jmercerr/CW312T-S6LX9/CW312T-S6LX9.kicad_pcb

## KiCad design CW312T-S6LX9.kicad_pcb (2024-12-19)

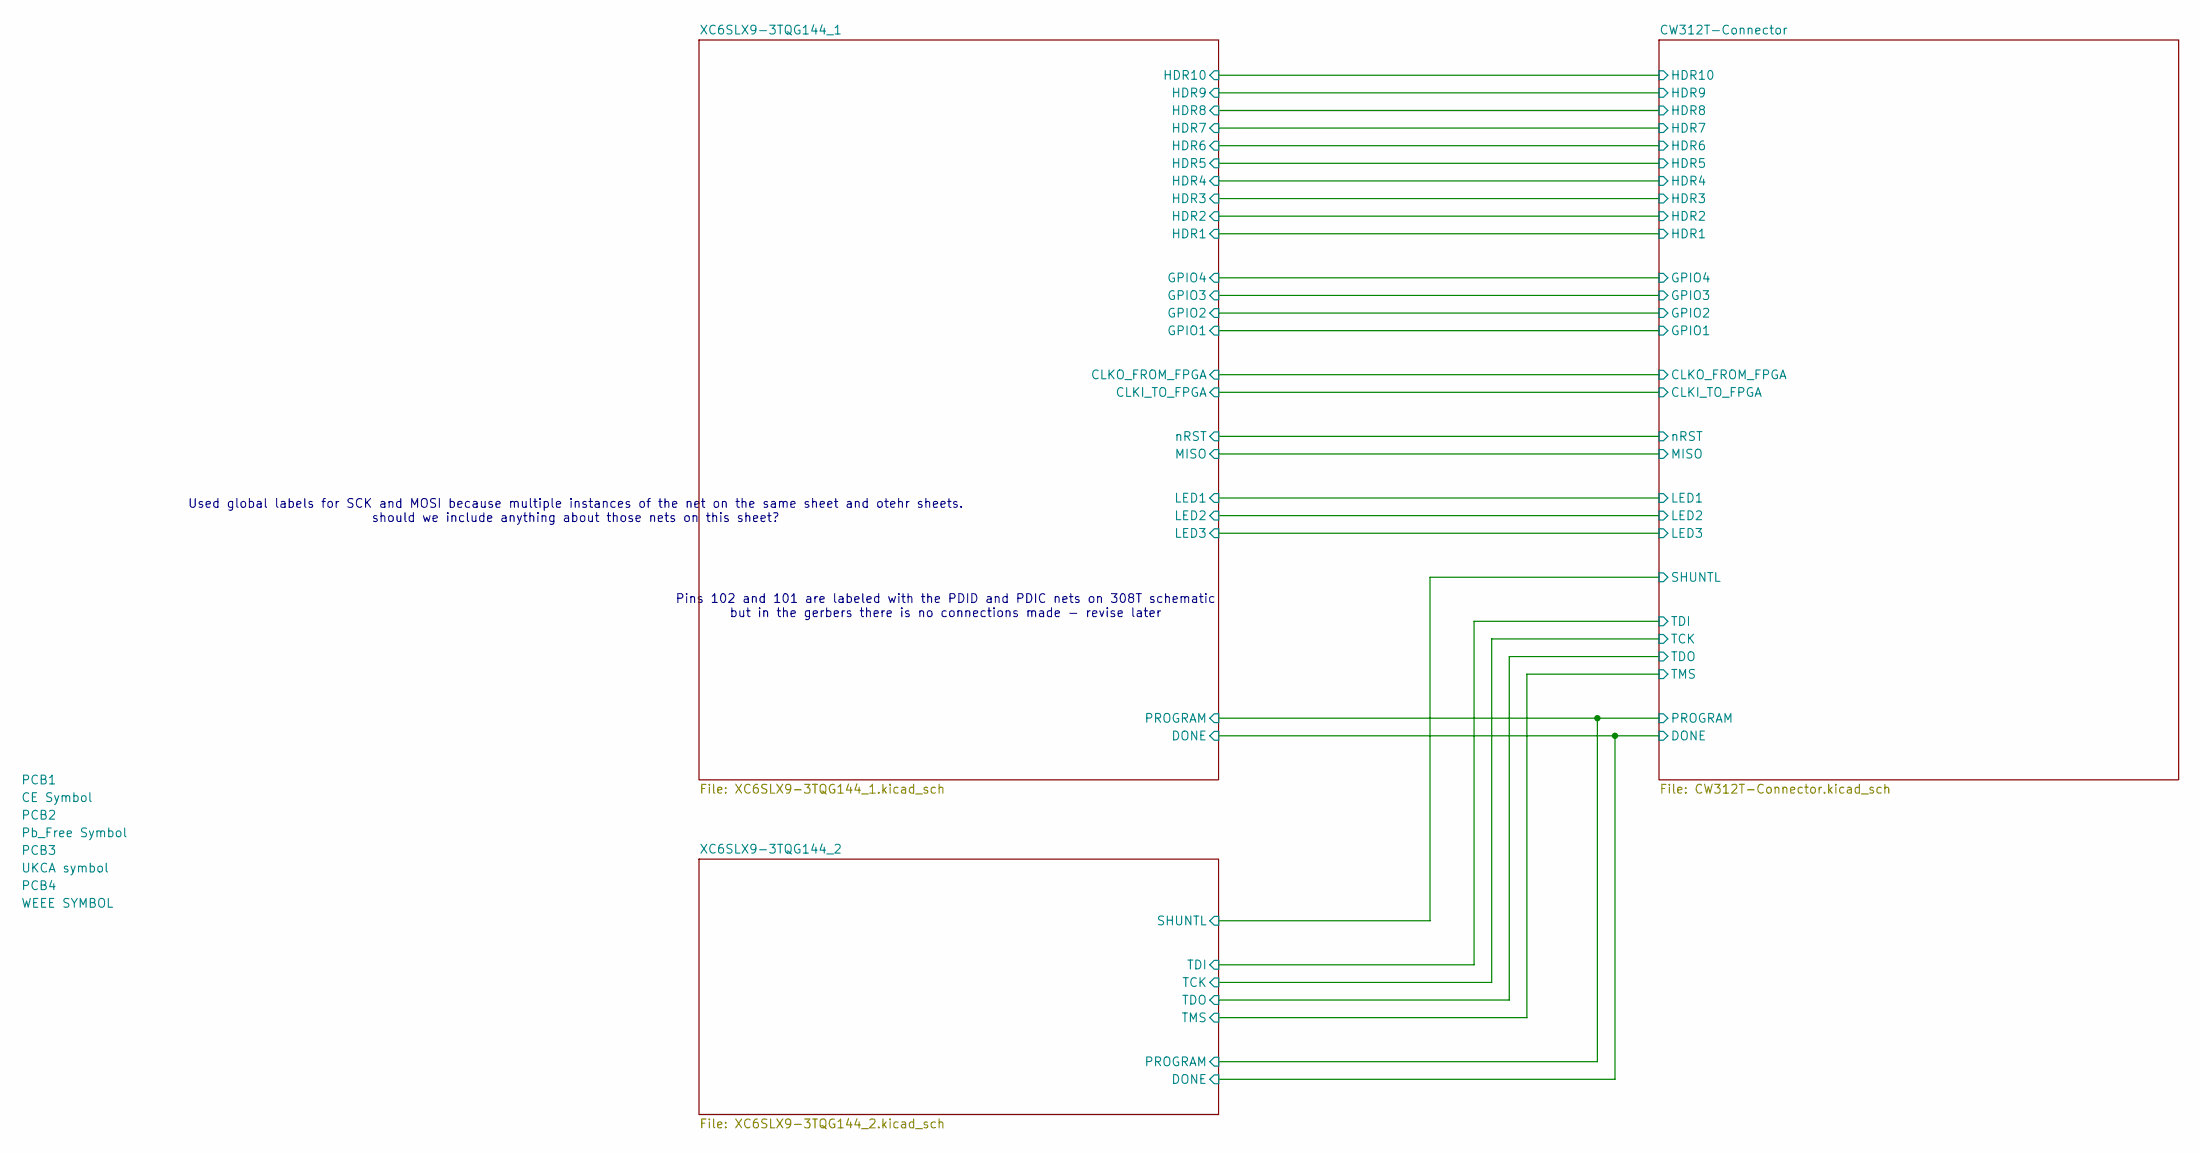
[picture p1: schematic CW312T-S6LX9.kicad_sch]

Parts:
PCB1: CE Symbol; CE-Logo_8.5x6mm_SilkScreen
PCB2: Pb_Free Symbol; Pb_Free_8.0x8.0mm_SilkScreen
PCB3: UKCA symbol; UKCA-Logo_8x8mm_SilkScreen
PCB4: WEEE SYMBOL; WEEE-Logo_5.6x8mm_SilkScreen

Notes on the sheet:
Pins 102 and 101 are labeled with the PDID and PDIC nets on 308T schematic but in the gerbers there is no connections made - revise later
Used global labels for SCK and MOSI because multiple instances of the net on the same sheet and otehr sheets. should we include anything about those nets on this sheet?

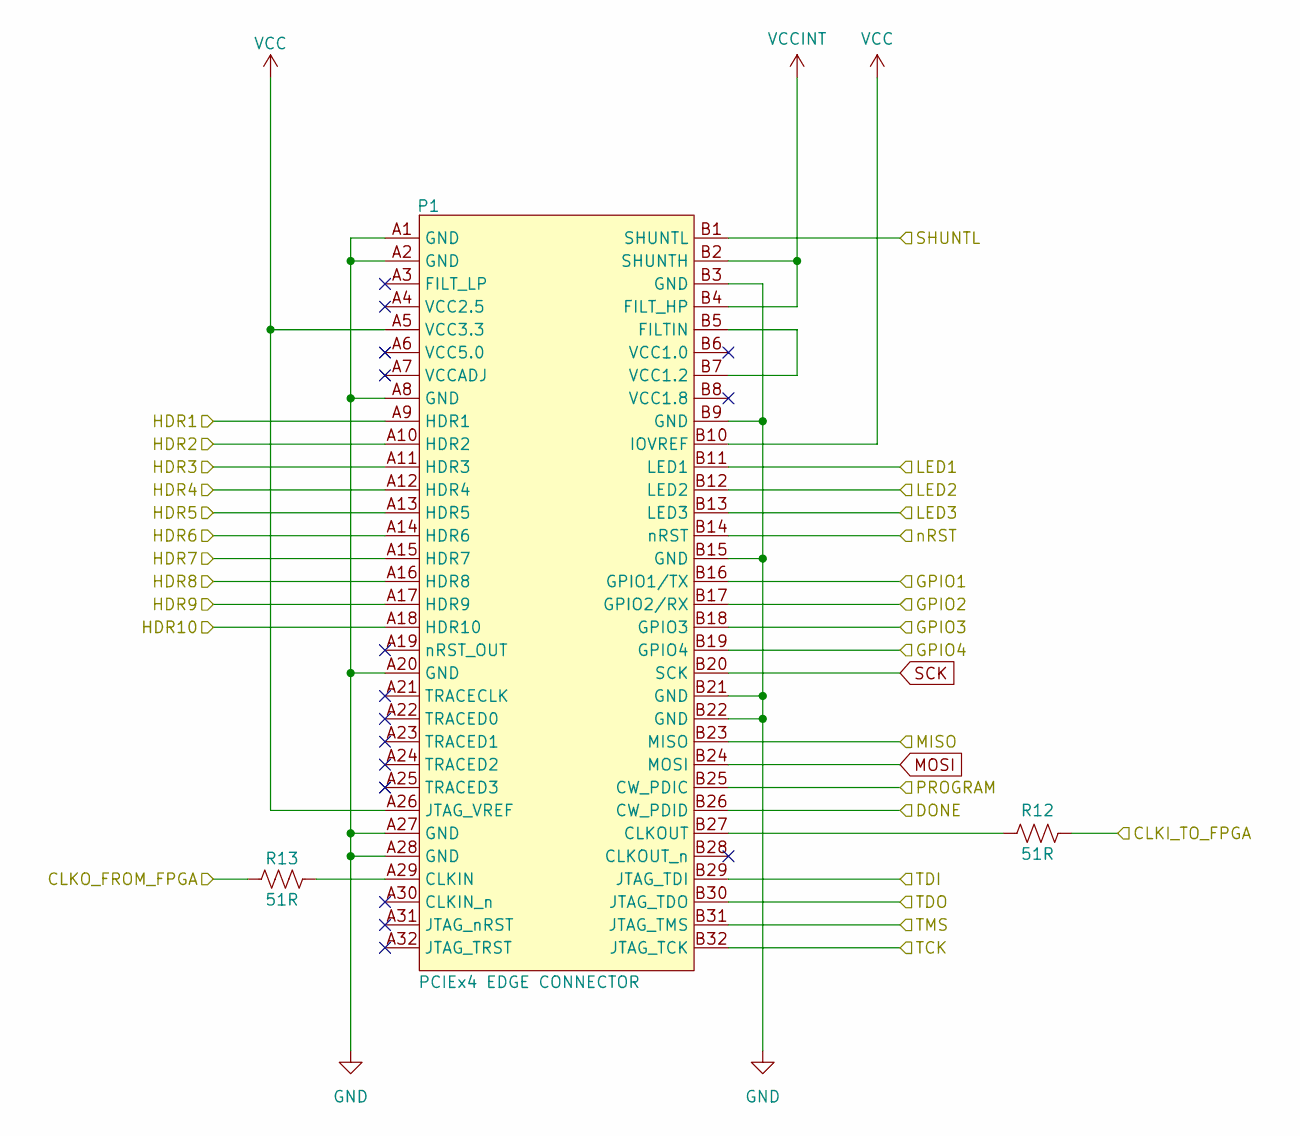
[picture p2: schematic CW312T-Connector.kicad_sch]

Parts:
P1: PCIEx4 EDGE CONNECTOR; CW312_Template
R12, R13: RES_51R_0603; R_0603_1608Metric; Manufacturer Part Number RC0603FR-0751RL

Connections:
/CW312T-Connector/CLKI_TO_FPGA: R12.2; also elsewhere on the board
/CW312T-Connector/CLKO_FROM_FPGA: R13.1; also elsewhere on the board
/CW312T-Connector/DONE: P1.B26 (CW_PDID); also elsewhere on the board
/CW312T-Connector/GPIO1: P1.B16 (GPIO1/TX); also elsewhere on the board
/CW312T-Connector/GPIO2: P1.B17 (GPIO2/RX); also elsewhere on the board
/CW312T-Connector/GPIO3: P1.B18 (GPIO3); also elsewhere on the board
/CW312T-Connector/GPIO4: P1.B19 (GPIO4); also elsewhere on the board
/CW312T-Connector/HDR1: P1.A9 (HDR1); also elsewhere on the board
/CW312T-Connector/HDR2: P1.A10 (HDR2); also elsewhere on the board
/CW312T-Connector/HDR3: P1.A11 (HDR3); also elsewhere on the board
/CW312T-Connector/HDR4: P1.A12 (HDR4); also elsewhere on the board
/CW312T-Connector/HDR5: P1.A13 (HDR5); also elsewhere on the board
/CW312T-Connector/HDR6: P1.A14 (HDR6); also elsewhere on the board
/CW312T-Connector/HDR7: P1.A15 (HDR7); also elsewhere on the board
/CW312T-Connector/HDR8: P1.A16 (HDR8); also elsewhere on the board
/CW312T-Connector/HDR9: P1.A17 (HDR9); also elsewhere on the board
/CW312T-Connector/HDR10: P1.A18 (HDR10); also elsewhere on the board
/CW312T-Connector/LED1: P1.B11 (LED1); also elsewhere on the board
/CW312T-Connector/LED2: P1.B12 (LED2); also elsewhere on the board
/CW312T-Connector/LED3: P1.B13 (LED3); also elsewhere on the board
/CW312T-Connector/MISO: P1.B23 (MISO); also elsewhere on the board
/CW312T-Connector/PROGRAM: P1.B25 (CW_PDIC); also elsewhere on the board
/CW312T-Connector/SHUNTL: P1.B1 (SHUNTL); also elsewhere on the board
/CW312T-Connector/TCK: P1.B32 (JTAG_TCK); also elsewhere on the board
/CW312T-Connector/TDI: P1.B29 (JTAG_TDI); also elsewhere on the board
/CW312T-Connector/TDO: P1.B30 (JTAG_TDO); also elsewhere on the board
/CW312T-Connector/TMS: P1.B31 (JTAG_TMS); also elsewhere on the board
/CW312T-Connector/nRST: P1.B14 (nRST); also elsewhere on the board
GND: P1.A1 (GND), P1.A2 (GND), P1.A8 (GND), P1.A20 (GND), P1.A27 (GND), P1.A28 (GND), P1.B3 (GND), P1.B9 (GND), P1.B15 (GND), P1.B21 (GND), P1.B22 (GND); also elsewhere on the board
MOSI: P1.B24 (MOSI); also elsewhere on the board
unnamed: P1.A29 (CLKIN), R13.2
unnamed: P1.B27 (CLKOUT), R12.1
unnamed: P1.B5 (FILTIN), P1.B7 (VCC1.2)
SCK: P1.B20 (SCK); also elsewhere on the board
VCC: P1.A5 (VCC3.3), P1.A26 (JTAG_VREF), P1.B10 (IOVREF); also elsewhere on the board
VCCINT: P1.B2 (SHUNTH), P1.B4 (FILT_HP); also elsewhere on the board

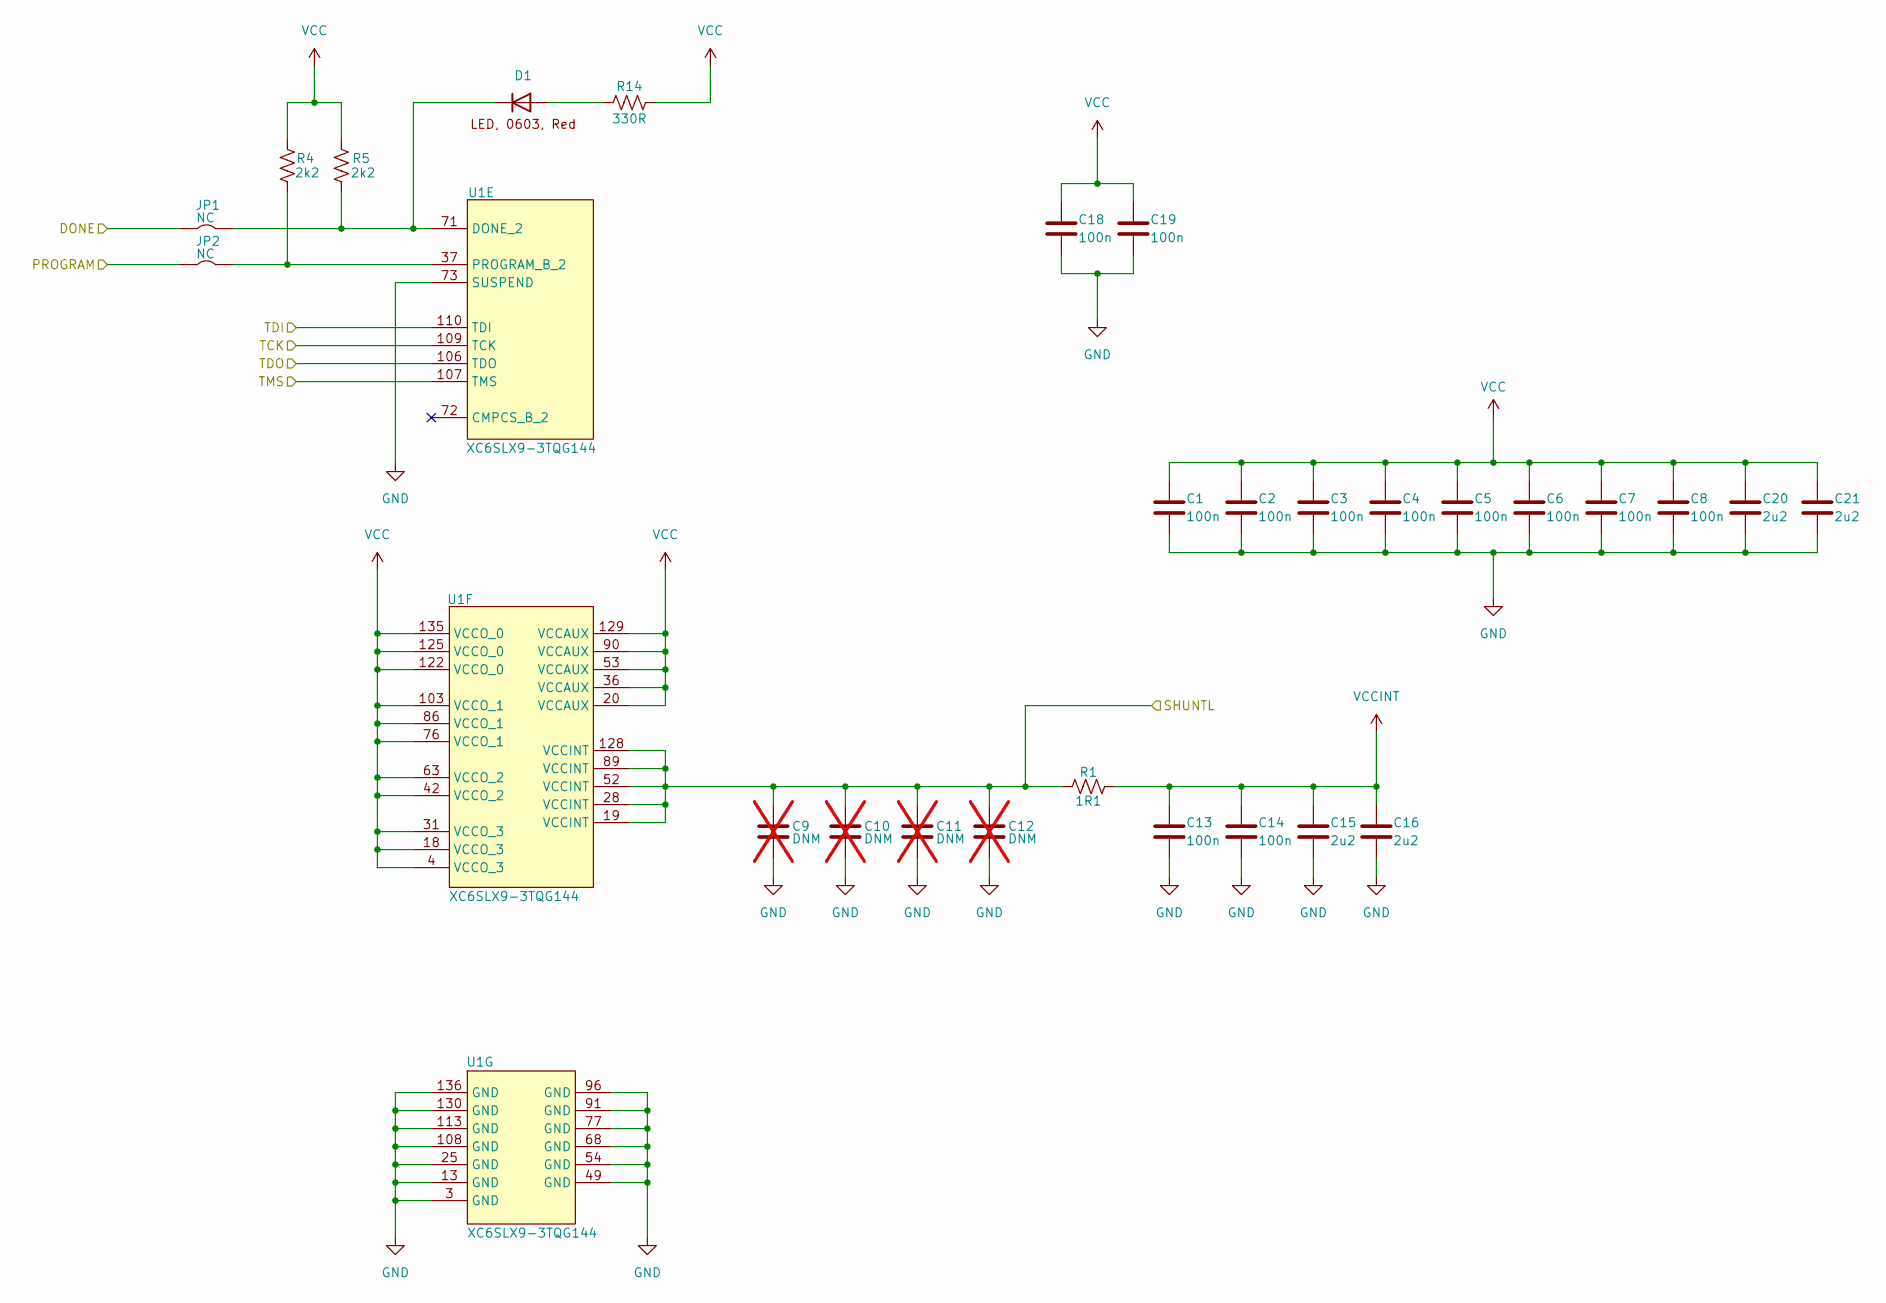
[picture p3: schematic XC6SLX9-3TQG144_2.kicad_sch]

Parts:
C1, C2, C3, C4, C5, C6, C7, C8, C13, C14, C18, C19: CAP_100n_6.3V_0603; C_0603_1608Metric; Manufacturer Part Number CC0603KRX7R5BB104
C9, C10, C11, C12: DNM_CAP_0603; C_0603_1608Metric; Manufacturer Part Number C0603C225K4PAC7867; not fitted
C15, C16, C20, C21: CAP_2u2_6.3V_0603; C_0603_1608Metric; Manufacturer Part Number CC0603KRX7R5BB225
D1: APT1608SRCPRV; LED_0603_1608Metric; Manufacturer Part Number APT1608SRCPRV
JP1, JP2: SolderJumper-2_P1.3mm_Bridged2Bar_Pad1.0x1.5mm
R1: RES_1R1_0603; R_0603_1608Metric; Manufacturer Part Number RC0603FR-101R1L
R4, R5: RES_2k2_0603; R_0603_1608Metric; Manufacturer Part Number RC0603FR-072K2L
R14: RES_330R_0603; R_0603_1608Metric; Manufacturer Part Number RC0603FR-07330RL
U1: XC6SLX9-3TQG144; TQFP-144_20x20mm_P0.5mm; Manufacturer Part Number XC6SLX9-3TQG144CXC6SLX9-3TQG144C

Connections:
/CW312T-Connector/DONE: JP1.1; also elsewhere on the board
/CW312T-Connector/PROGRAM: JP2.1; also elsewhere on the board
/CW312T-Connector/SHUNTL: C9.2, C10.2, C11.2, C12.2, R1.1, U1.19 (VCCINT), U1.28 (VCCINT), U1.52 (VCCINT), U1.89 (VCCINT), U1.128 (VCCINT); also elsewhere on the board
/CW312T-Connector/TCK: U1.109 (TCK); also elsewhere on the board
/CW312T-Connector/TDI: U1.110 (TDI); also elsewhere on the board
/CW312T-Connector/TDO: U1.106 (TDO); also elsewhere on the board
/CW312T-Connector/TMS: U1.107 (TMS); also elsewhere on the board
GND: C1.2, C2.2, C3.2, C4.2, C5.2, C6.2, C7.2, C8.2, C9.1, C10.1, C11.1, C12.1, C13.2, C14.2, C15.2, C16.2, C18.2, C19.2, C20.2, C21.2, U1.3 (GND), U1.13 (GND), U1.25 (GND), U1.49 (GND), U1.54 (GND), U1.68 (GND), U1.73 (SUSPEND), U1.77 (GND), U1.91 (GND), U1.96 (GND), U1.108 (GND), U1.113 (GND), U1.130 (GND), U1.136 (GND); also elsewhere on the board
unnamed: D1.2, R14.1
unnamed: D1.1, JP1.2, R5.1, U1.71 (DONE_2)
unnamed: JP2.2, R4.1, U1.37 (PROGRAM_B_2)
VCC: C1.1, C2.1, C3.1, C4.1, C5.1, C6.1, C7.1, C8.1, C18.1, C19.1, C20.1, C21.1, R4.2, R5.2, R14.2, U1.4 (VCCO_3), U1.18 (VCCO_3), U1.20 (VCCAUX), U1.31 (VCCO_3), U1.36 (VCCAUX), U1.42 (VCCO_2), U1.53 (VCCAUX), U1.63 (VCCO_2), U1.76 (VCCO_1), U1.86 (VCCO_1), U1.90 (VCCAUX), U1.103 (VCCO_1), U1.122 (VCCO_0), U1.125 (VCCO_0), U1.129 (VCCAUX), U1.135 (VCCO_0); also elsewhere on the board
VCCINT: C13.1, C14.1, C15.1, C16.1, R1.2; also elsewhere on the board

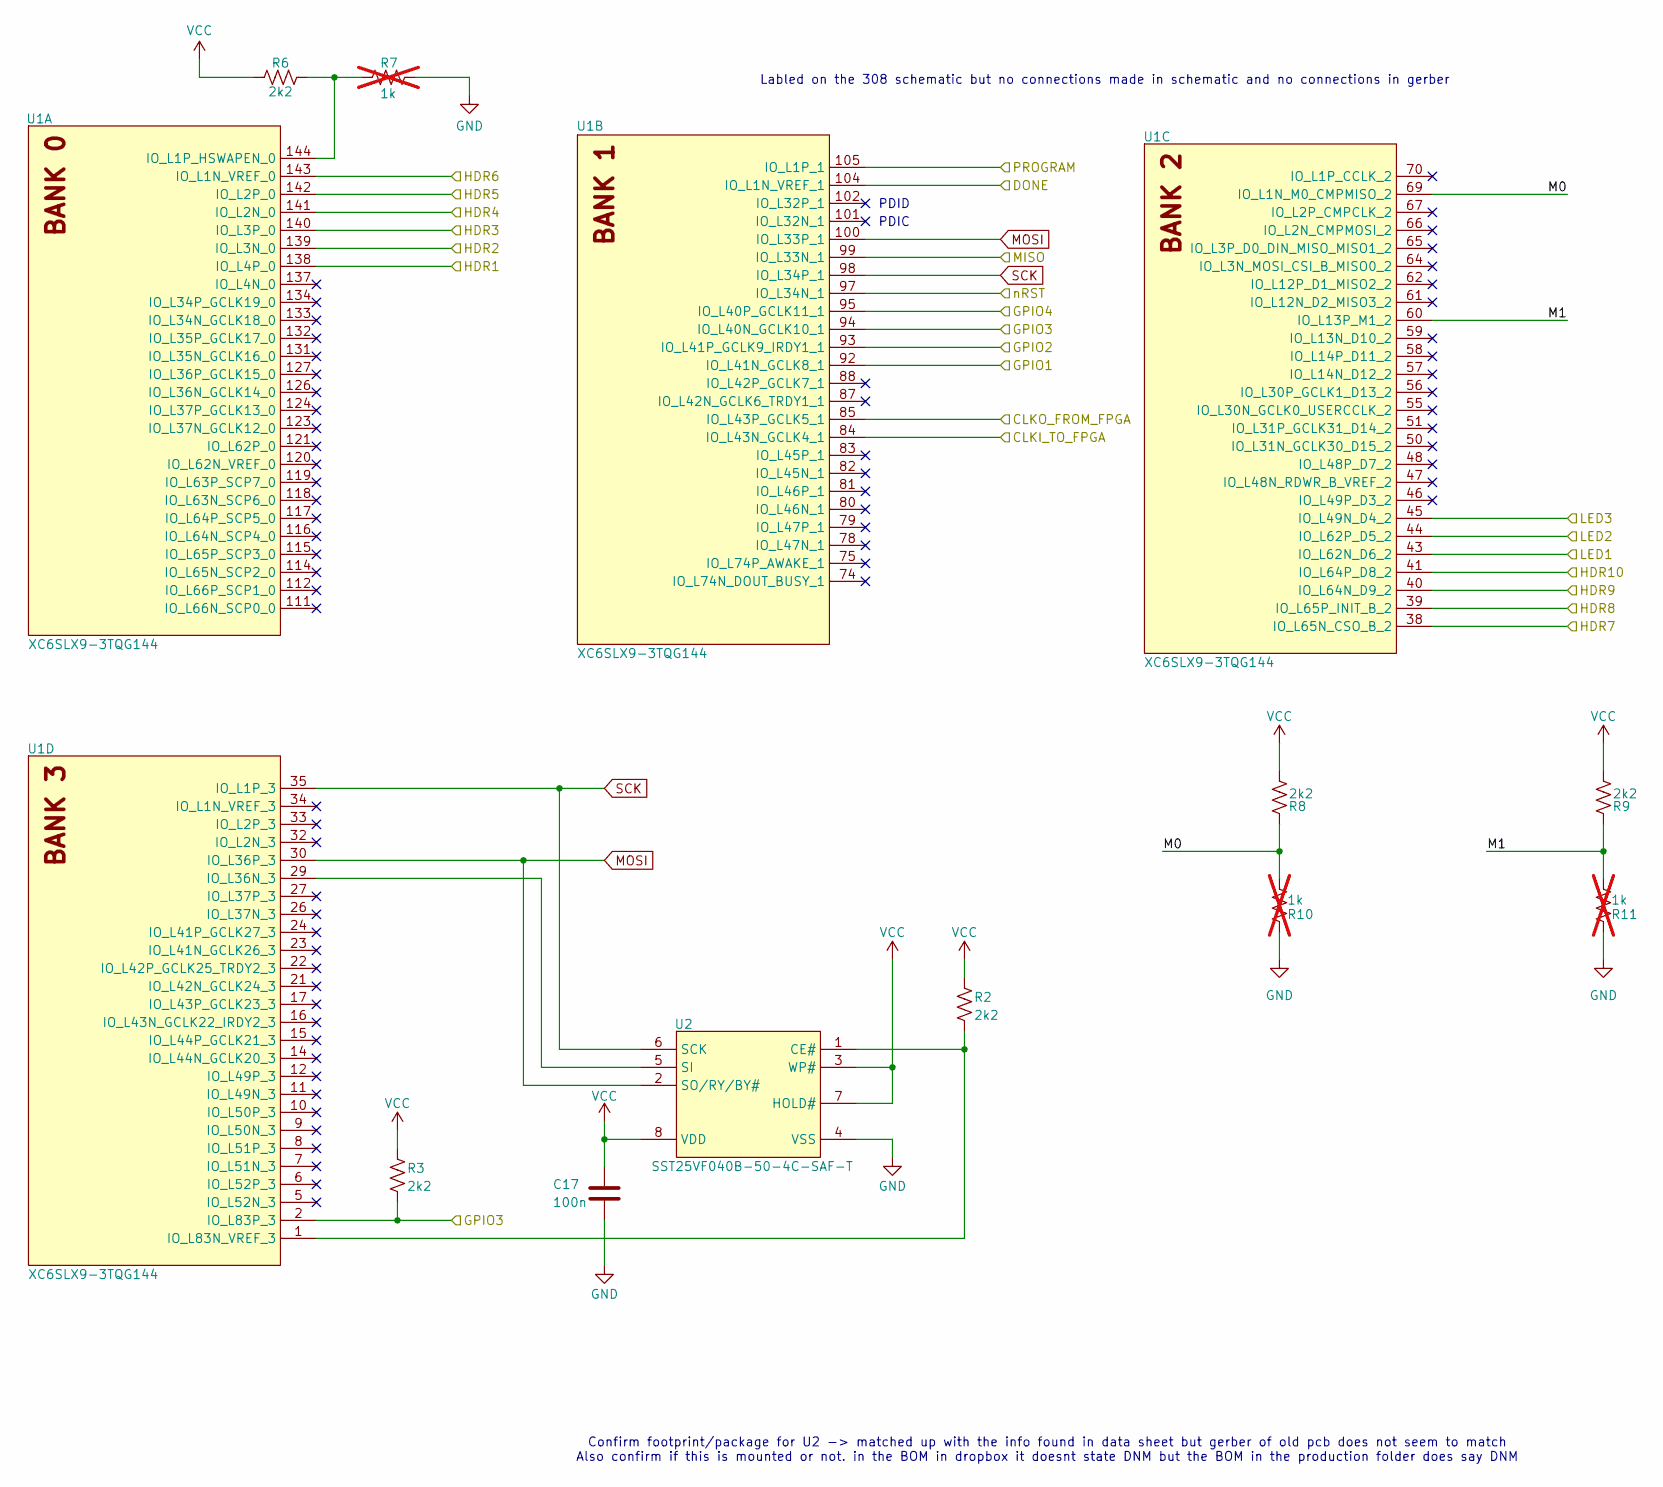
[picture p4: schematic XC6SLX9-3TQG144_1.kicad_sch]

Parts:
C17: CAP_100n_6.3V_0603; C_0603_1608Metric; Manufacturer Part Number CC0603KRX7R5BB104
R2, R3, R6, R8, R9: RES_2k2_0603; R_0603_1608Metric; Manufacturer Part Number RC0603FR-072K2L
R7, R10, R11: RES_1k_0603; R_0603_1608Metric; Manufacturer Part Number RC0603FR-071KL; not fitted
U1: XC6SLX9-3TQG144; TQFP-144_20x20mm_P0.5mm; Manufacturer Part Number XC6SLX9-3TQG144CXC6SLX9-3TQG144C
U2: SST25VF040B-50-4C-SAF-T; SOIC-8_5.275x5.275mm_P1.27mm; Manufacturer Part Number SST25VF040B-50-4C-SAF-T

Connections:
/CW312T-Connector/CLKI_TO_FPGA: U1.84 (IO_L43N_GCLK4_1); also elsewhere on the board
/CW312T-Connector/CLKO_FROM_FPGA: U1.85 (IO_L43P_GCLK5_1); also elsewhere on the board
/CW312T-Connector/DONE: U1.104 (IO_L1N_VREF_1); also elsewhere on the board
/CW312T-Connector/GPIO1: U1.92 (IO_L41N_GCLK8_1); also elsewhere on the board
/CW312T-Connector/GPIO2: U1.93 (IO_L41P_GCLK9_IRDY1_1); also elsewhere on the board
/CW312T-Connector/GPIO3: R3.1, U1.2 (IO_L83P_3), U1.94 (IO_L40N_GCLK10_1); also elsewhere on the board
/CW312T-Connector/GPIO4: U1.95 (IO_L40P_GCLK11_1); also elsewhere on the board
/CW312T-Connector/HDR1: U1.138 (IO_L4P_0); also elsewhere on the board
/CW312T-Connector/HDR2: U1.139 (IO_L3N_0); also elsewhere on the board
/CW312T-Connector/HDR3: U1.140 (IO_L3P_0); also elsewhere on the board
/CW312T-Connector/HDR4: U1.141 (IO_L2N_0); also elsewhere on the board
/CW312T-Connector/HDR5: U1.142 (IO_L2P_0); also elsewhere on the board
/CW312T-Connector/HDR6: U1.143 (IO_L1N_VREF_0); also elsewhere on the board
/CW312T-Connector/HDR7: U1.38 (IO_L65N_CSO_B_2); also elsewhere on the board
/CW312T-Connector/HDR8: U1.39 (IO_L65P_INIT_B_2); also elsewhere on the board
/CW312T-Connector/HDR9: U1.40 (IO_L64N_D9_2); also elsewhere on the board
/CW312T-Connector/HDR10: U1.41 (IO_L64P_D8_2); also elsewhere on the board
/CW312T-Connector/LED1: U1.43 (IO_L62N_D6_2); also elsewhere on the board
/CW312T-Connector/LED2: U1.44 (IO_L62P_D5_2); also elsewhere on the board
/CW312T-Connector/LED3: U1.45 (IO_L49N_D4_2); also elsewhere on the board
/CW312T-Connector/MISO: U1.99 (IO_L33N_1); also elsewhere on the board
/CW312T-Connector/PROGRAM: U1.105 (IO_L1P_1); also elsewhere on the board
/CW312T-Connector/nRST: U1.97 (IO_L34N_1); also elsewhere on the board
/XC6SLX9-3TQG144_1/M0: R8.1, R10.2, U1.69 (IO_L1N_M0_CMPMISO_2)
/XC6SLX9-3TQG144_1/M1: R9.1, R11.2, U1.60 (IO_L13P_M1_2)
GND: C17.2, R7.1, R10.1, R11.1, U2.4 (VSS); also elsewhere on the board
MOSI: U1.30 (IO_L36P_3), U1.100 (IO_L33P_1), U2.2 (SO/RY/BY#); also elsewhere on the board
unnamed: R6.2, R7.2, U1.144 (IO_L1P_HSWAPEN_0)
unnamed: U1.29 (IO_L36N_3), U2.5 (SI)
unnamed: R2.1, U1.1 (IO_L83N_VREF_3), U2.1 (CE#)
SCK: U1.35 (IO_L1P_3), U1.98 (IO_L34P_1), U2.6 (SCK); also elsewhere on the board
VCC: C17.1, R2.2, R3.2, R6.1, R8.2, R9.2, U2.3 (WP#), U2.7 (HOLD#), U2.8 (VDD); also elsewhere on the board

Notes on the sheet:
PDID
Labled on the 308 schematic but no connections made in schematic and no connections in gerber
PDIC
Confirm footprint/package for U2 -> matched up with the info found in data sheet but gerber of old pcb does not seem to match Also confirm if this is mounted or not. in the BOM in dropbox it doesnt state DNM but the BOM in the production folder does say DNM

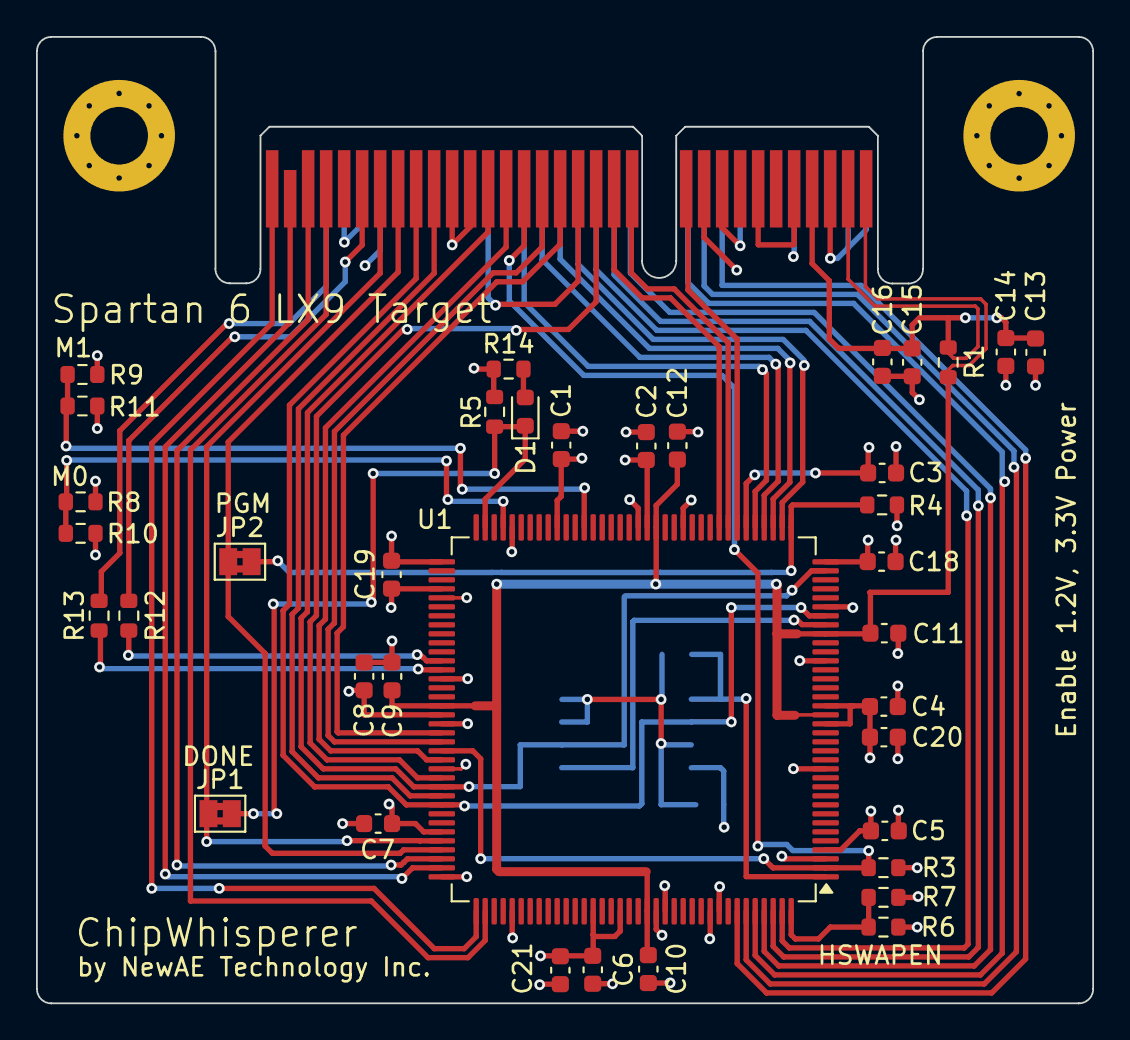
[picture p5: board CW312T-S6LX9.kicad_pcb from above]

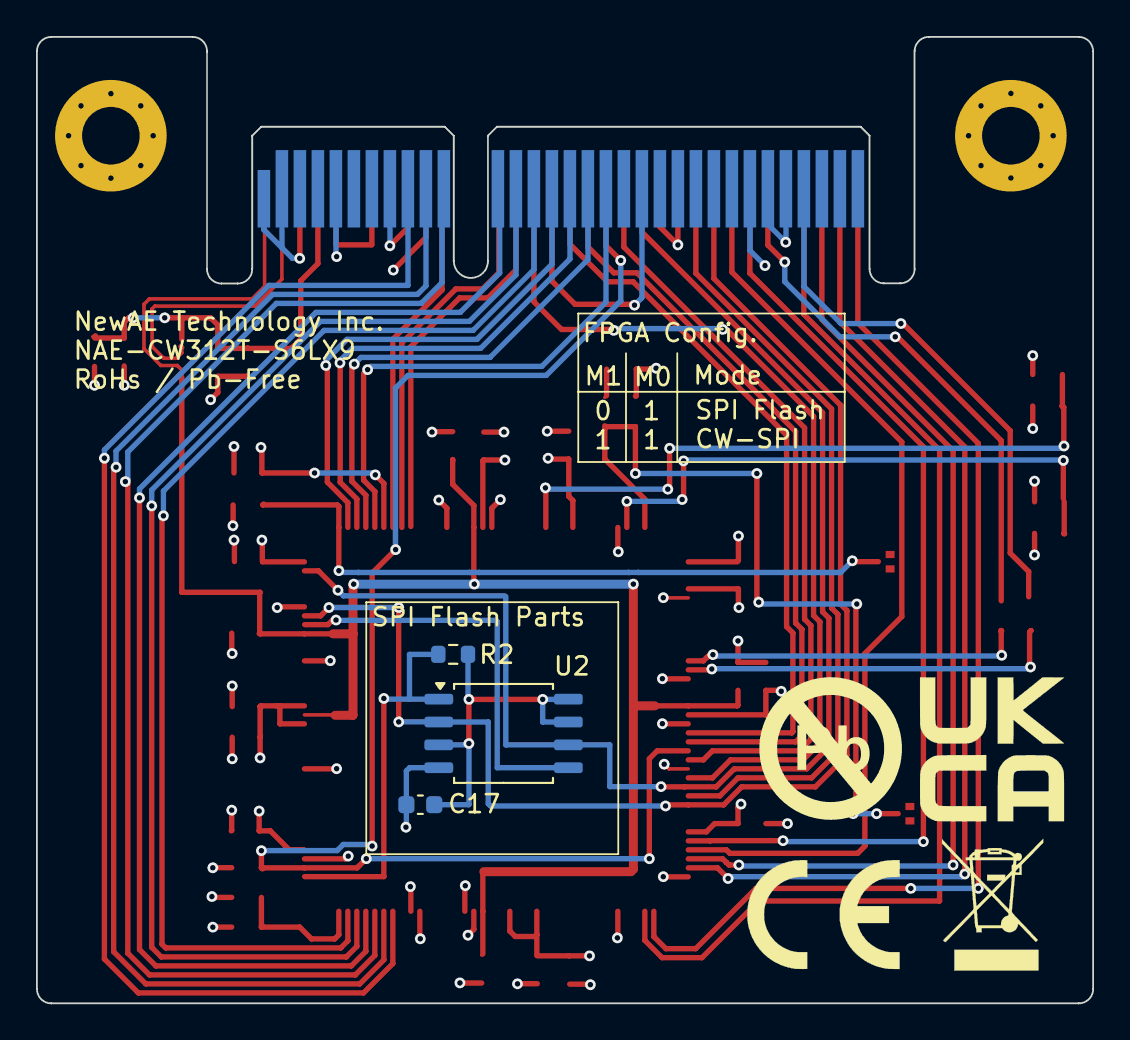
[picture p6: board CW312T-S6LX9.kicad_pcb from below]

Board: 4 copper layers, 58.7 x 53.7 mm, 45 parts (3 on the bottom side), 44 nets.
