jmercerr/CW312T-S6LX9/(commit log)

2024-11-21 updated design - still needs vcc routing
    [CW312T-Connector.kicad_sch, CW312T-S6LX9.kicad_pcb, CW312T-S6LX9.kicad_sch, XC6SLX9-3TQG144_1.kicad_sch, XC6SLX9-3TQG144_2.kicad_sch]
2024-11-22 updated cw312t template
    [CW312T-Connector.kicad_sch, CW312T-S6LX9.kicad_pcb, XC6SLX9-3TQG144_1.kicad_sch, XC6SLX9-3TQG144_2.kicad_sch]
2024-11-22 added inner layers for gnd and pwr planes, added silkscreen, updated cw312t template
    [CW312T-S6LX9.kicad_pcb, CW312T-S6LX9.kicad_sch]
2024-11-26 first draft - ready for review
    [CW312T-S6LX9.kicad_pcb, XC6SLX9-3TQG144_1.kicad_sch]
2024-12-03 updated schematic and pcb, fixed silkscreen - Ready for review
    [CW312T-Connector.kicad_sch, CW312T-S6LX9.kicad_pcb, CW312T-S6LX9.kicad_sch, XC6SLX9-3TQG144_1.kicad_sch, XC6SLX9-3TQG144_2.kicad_sch]
2024-12-03 updated note on schematic
    [XC6SLX9-3TQG144_1.kicad_sch]
2024-12-19 updated schematic and pcb after library re-organization
    [CW312T-Connector.kicad_sch, CW312T-S6LX9.kicad_pcb, XC6SLX9-3TQG144_1.kicad_sch, XC6SLX9-3TQG144_2.kicad_sch]
2024-12-19 updated pcb and schematic after library re-organization
    [CW312T-S6LX9.kicad_pcb, XC6SLX9-3TQG144_1.kicad_sch, XC6SLX9-3TQG144_2.kicad_sch]
